bazhenov/eload/3d/heatsink.step

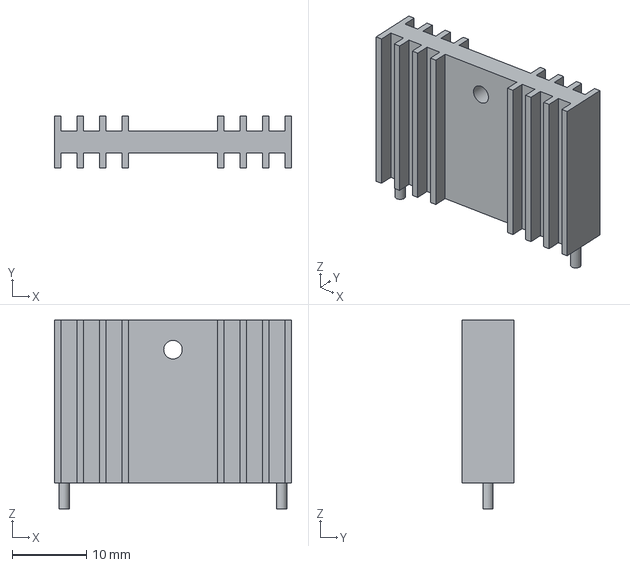
[picture p1: CAD file, 2026-01-11]
3d/heatsink.step
32.0 x 7.00 x 25.5 mm
