bazhenov/eload/3d/G5Q-1-EU_DC12.stp

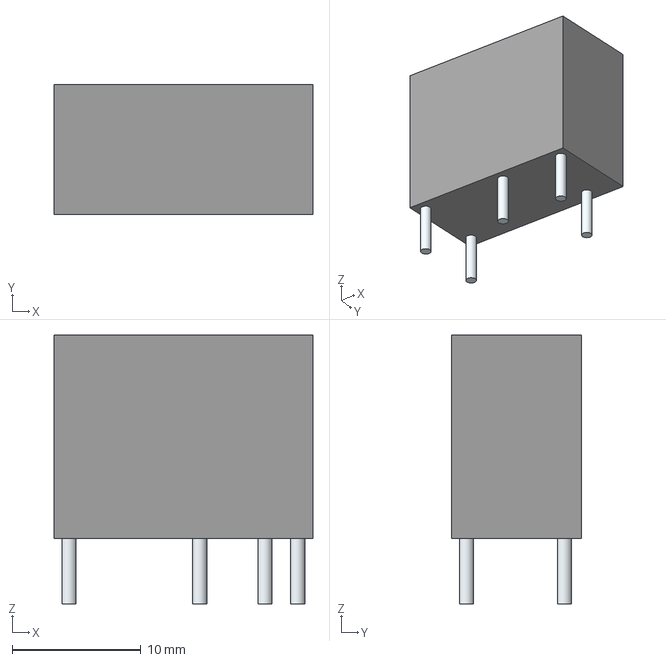
[picture p2: CAD file, 2026-01-10]
3d/G5Q-1-EU_DC12.stp
20.1 x 10.2 x 20.9 mm
Leads
