bazhenov/eload/(list of files, cad)

Other CAD files:
3d/heatsink.FCStd
