bazhenov/eload/eload.kicad_pcb

## KiCad design eload.kicad_pcb (2026-01-17)

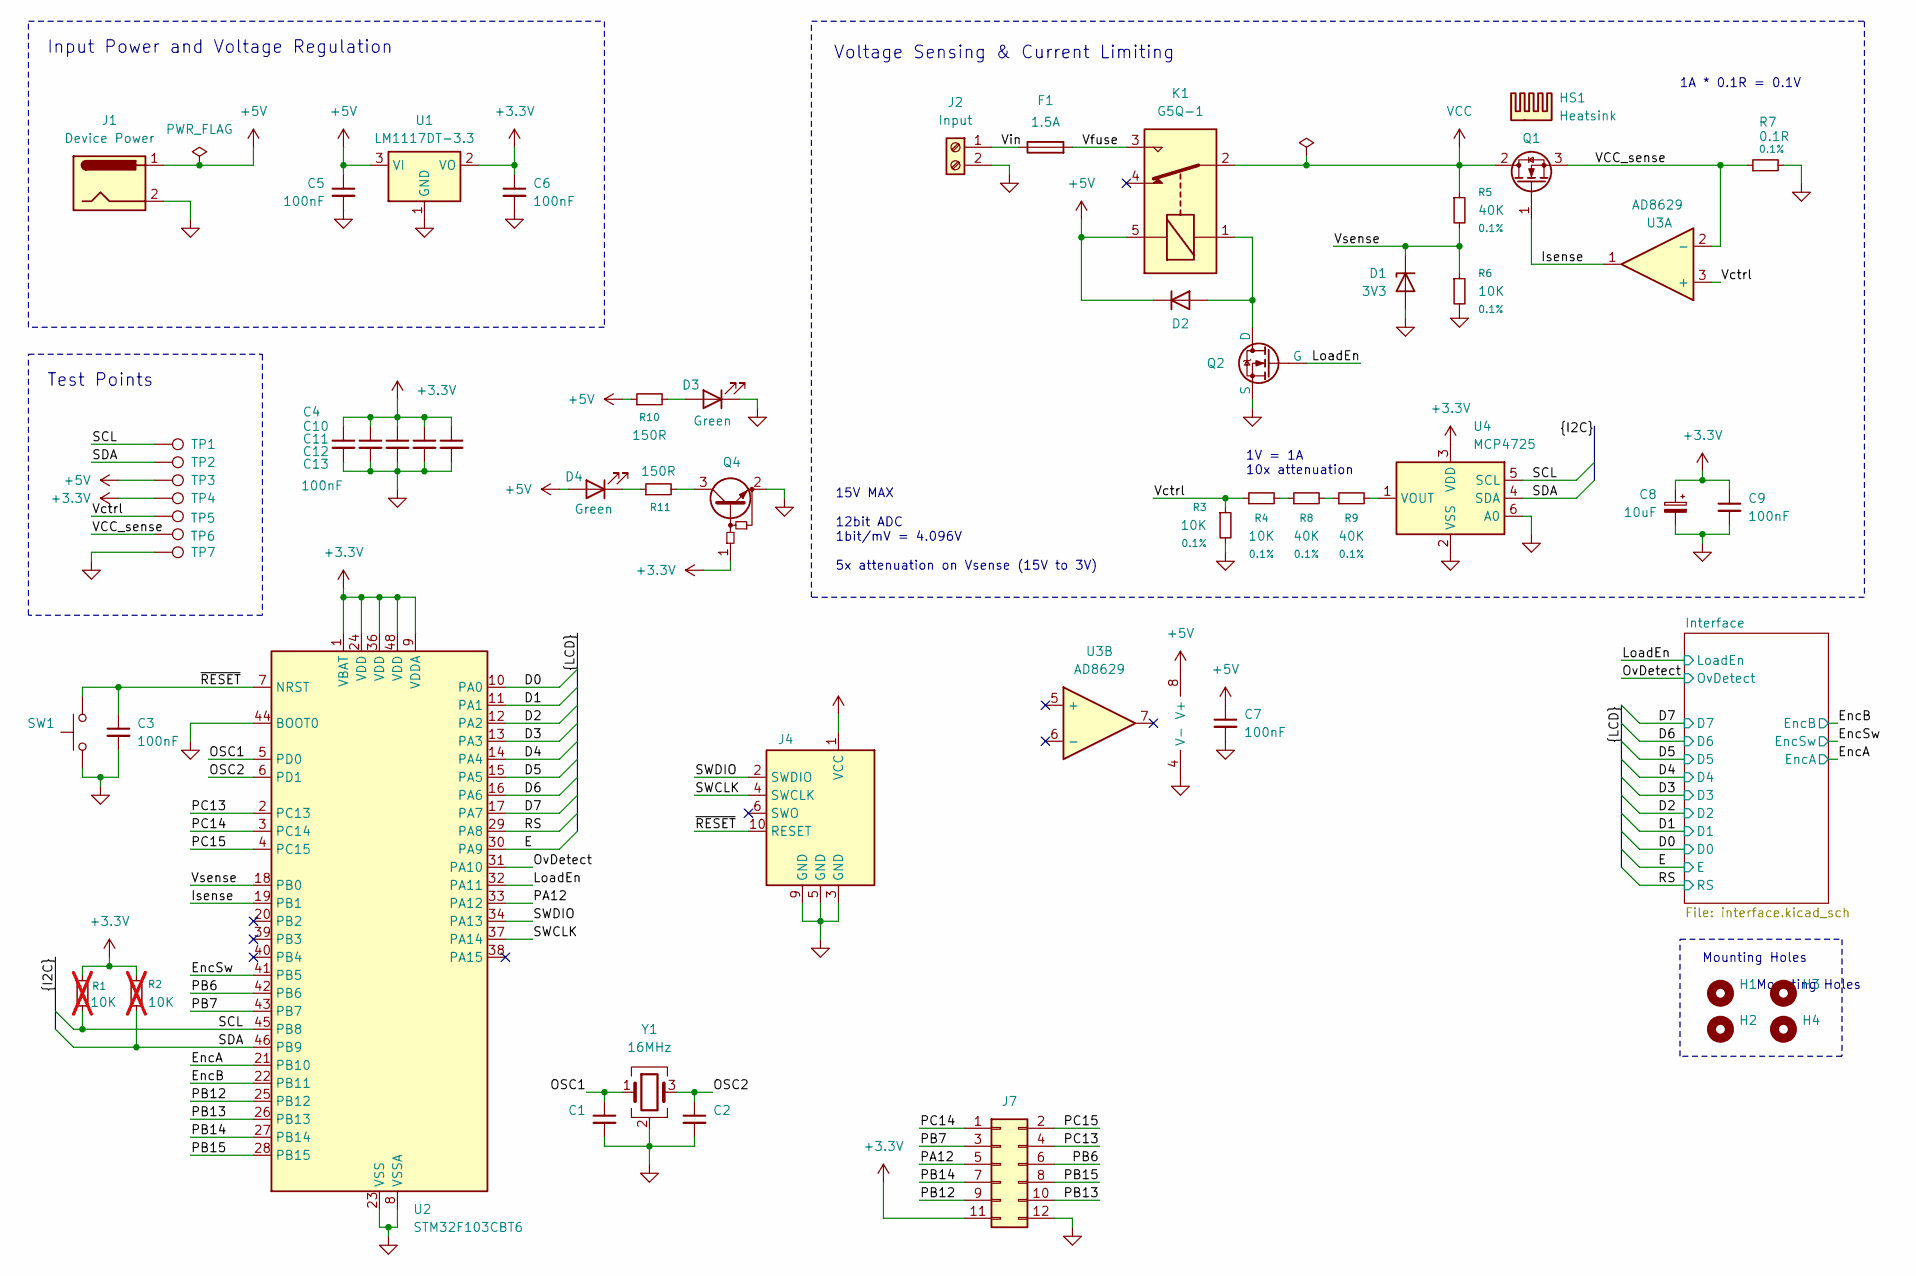
[picture p3: schematic eload.kicad_sch, Bench Electronic Load]

Parts:
C1, C2: 20pF; C_0805_2012Metric_Pad1.18x1.45mm_HandSolder; LCSC Part # C149606
C3, C4, C5, C6, C7, C9, C10, C11, C12, C13: 100nF; C_0805_2012Metric_Pad1.18x1.45mm_HandSolder; LCSC Part # C49678
C8: 10uF; CP_EIA-3216-18_Kemet-A_HandSolder; LCSC Part # C110055
D1: BZT52C3V3S; D_SOD-323_HandSoldering; LCSC Part # C507913
D2: MBR120VLSFT1G; D_SOD-123F; LCSC Part # C223608
D3, D4: 17-215/GHC-YR1S2/4T; LED_0805_2012Metric_Pad1.15x1.40mm_HandSolder; LCSC Part # C2985995
F1: 1.5A; R_Axial_DIN0204_L3.6mm_D1.6mm_P7.62mm_Horizontal; LCSC Part # C178932
H1, H2, H3, H4: MountingHole; MountingHole_3.2mm_M3_DIN965
HS1: Heatsink; XSD1226-362; LCSC Part # C4657
J1: Device Power; BarrelJack_Horizontal; LCSC Part # C7498153
J2: Input; TerminalBlock_CUI_TB007-508-02_1x02_P5.08mm_Horizontal; LCSC Part # C8465
J4: SWD Header; IDC-Header_2x05_P2.54mm_Vertical; LCSC Part # C5665
J7: Conn_02x06_Odd_Even; PinHeader_2x06_P2.54mm_Vertical
K1: G5Q-1; Relay_SPDT_Omron-G5Q-1; LCSC Part # C397241
Q1: RFP30N06LE-VB; TO-220-3_Vertical; LCSC Part # C878812
Q2: HL 40N05; SOT-23-3; LCSC Part # C7543825
Q4: DTC043ZUBTL; SOT-323_SC-70; LCSC Part # C962655
R1, R2: 10K; R_0805_2012Metric_Pad1.20x1.40mm_HandSolder; LCSC Part # C110775; not fitted
R3, R4, R6: 10K; R_0805_2012Metric_Pad1.20x1.40mm_HandSolder; LCSC Part # C110775
R5, R8, R9: 40K; R_0805_2012Metric_Pad1.20x1.40mm_HandSolder; LCSC Part # C865475
R7: 0.1R; R_1206_3216Metric_Pad1.30x1.75mm_HandSolder; LCSC Part # C7467250
R10, R11: 150R; R_0805_2012Metric_Pad1.20x1.40mm_HandSolder; LCSC Part # C844818
SW1: SW_Push
TP1, TP2, TP7: TestPoint; TestPoint_Loop_D1.80mm_Drill1.0mm_Beaded
TP3, TP4, TP5, TP6: TestPoint; TestPoint_Pad_D1.5mm
U1: LM1117DT-3.3; SOT-223; LCSC Part # C126027
U2: STM32F103CBT6; LQFP-48_7x7mm_P0.5mm; LCSC Part # C8304
U3: AD8629; JEITA_SOIC-8_3.9x4.9mm_P1.27mm; LCSC Part # C653045
U4: MCP4725; SOT-23-6; LCSC Part # C144198
Y1: 16MHz; Crystal_SMD_3225-4Pin_3.2x2.5mm_HandSoldering; LCSC Part # C13738

Connections:
+3.3V: C4.1, C6.1, C8.1, C9.1, C10.1, C11.1, C12.1, C13.1, J4.1 (VCC), J7.11, Q4.1 (B), R1.1, R2.1, TP4.1, U1.2 (VO), U2.1 (VBAT), U2.9 (VDDA), U2.24 (VDD), U2.36 (VDD), U2.48 (VDD), U4.3 (VDD); also elsewhere on the board
+5V: C5.1, C7.1, D2.1 (K), D4.2 (A), J1.1, K1.5, R10.1, TP3.1, U1.3 (VI), U3.8 (V+); also elsewhere on the board
/D0: U2.10 (PA0); also elsewhere on the board
/D1: U2.11 (PA1); also elsewhere on the board
/D2: U2.12 (PA2); also elsewhere on the board
/D3: U2.13 (PA3); also elsewhere on the board
/D4: U2.14 (PA4); also elsewhere on the board
/D5: U2.15 (PA5); also elsewhere on the board
/D6: U2.16 (PA6); also elsewhere on the board
/D7: U2.17 (PA7); also elsewhere on the board
/E: U2.30 (PA9); also elsewhere on the board
/EncA: U2.21 (PB10); also elsewhere on the board
/EncB: U2.22 (PB11); also elsewhere on the board
/EncSw: U2.41 (PB5); also elsewhere on the board
/Isense: Q1.1 (G), U2.19 (PB1), U3.1
/LoadEn: Q2.2 (G), U2.32 (PA11); also elsewhere on the board
/OSC1: C1.1, U2.5 (PD0), Y1.1
/OSC2: C2.1, U2.6 (PD1), Y1.3
/OvDetect: U2.31 (PA10); also elsewhere on the board
/PA12: J7.5, U2.33 (PA12)
/PB6: J7.6, U2.42 (PB6)
/PB7: J7.3, U2.43 (PB7)
/PB12: J7.9, U2.25 (PB12)
/PB13: J7.10, U2.26 (PB13)
/PB14: J7.7, U2.27 (PB14)
/PB15: J7.8, U2.28 (PB15)
/PC13: J7.4, U2.2 (PC13)
/PC14: J7.1, U2.3 (PC14)
/PC15: J7.2, U2.4 (PC15)
/RS: U2.29 (PA8); also elsewhere on the board
/SCL: R1.2, TP1.1, U2.45 (PB8), U4.5 (SCL)
/SDA: R2.2, TP2.1, U2.46 (PB9), U4.4 (SDA)
/SWCLK: J4.4 (SWCLK), U2.37 (PA14)
/SWDIO: J4.2 (SWDIO), U2.34 (PA13)
/VCC_sense: Q1.3 (S), R7.1, TP6.1, U3.2 (-)
/Vctrl: R3.1, R4.1, TP5.1, U3.3 (+)
/Vfuse: F1.2, K1.3
/Vin: F1.1, J2.1
/Vsense: D1.1 (K), R5.2, R6.1, U2.18 (PB0)
/~RESET: C3.1, J4.10 (RESET), SW1.2, U2.7 (NRST)
GND: C1.2, C2.2, C3.2, C4.2, C5.2, C6.2, C7.2, C8.2, C9.2, C10.2, C11.2, C12.2, C13.2, D1.2 (A), D3.1 (K), J1.2, J2.2, J4.3 (GND), J4.5 (GND), J4.9 (GND), J7.12, Q2.3 (S), Q4.2 (E), R3.2, R6.2, R7.2, SW1.1, TP7.1, U1.1 (GND), U2.8 (VSSA), U2.23 (VSS), U2.35 (VSS), U2.44 (BOOT0), U2.47 (VSS), U3.4 (V-), U4.2 (VSS), U4.6 (A0), Y1.2 (G), Y1.4 (G); also elsewhere on the board
unnamed: D2.2 (A), K1.1, Q2.1 (D)
unnamed: D3.2 (A), R10.2
unnamed: D4.1 (K), R11.1
unnamed: Q4.3 (C), R11.2
unnamed: R4.2, R8.1
unnamed: R8.2, R9.1
unnamed: R9.2, U4.1 (VOUT)
VCC: K1.2, Q1.2 (D), R5.1

Notes on the sheet:
Test Points
Voltage Sensing & Current Limiting
Input Power and Voltage Regulation
15V MAX 12bit ADC 1bit/mV = 4.096V 5x attenuation on Vsense (15V to 3V)
1A * 0.1R = 0.1V
1V = 1A 10x attenuation
Mounting Holes

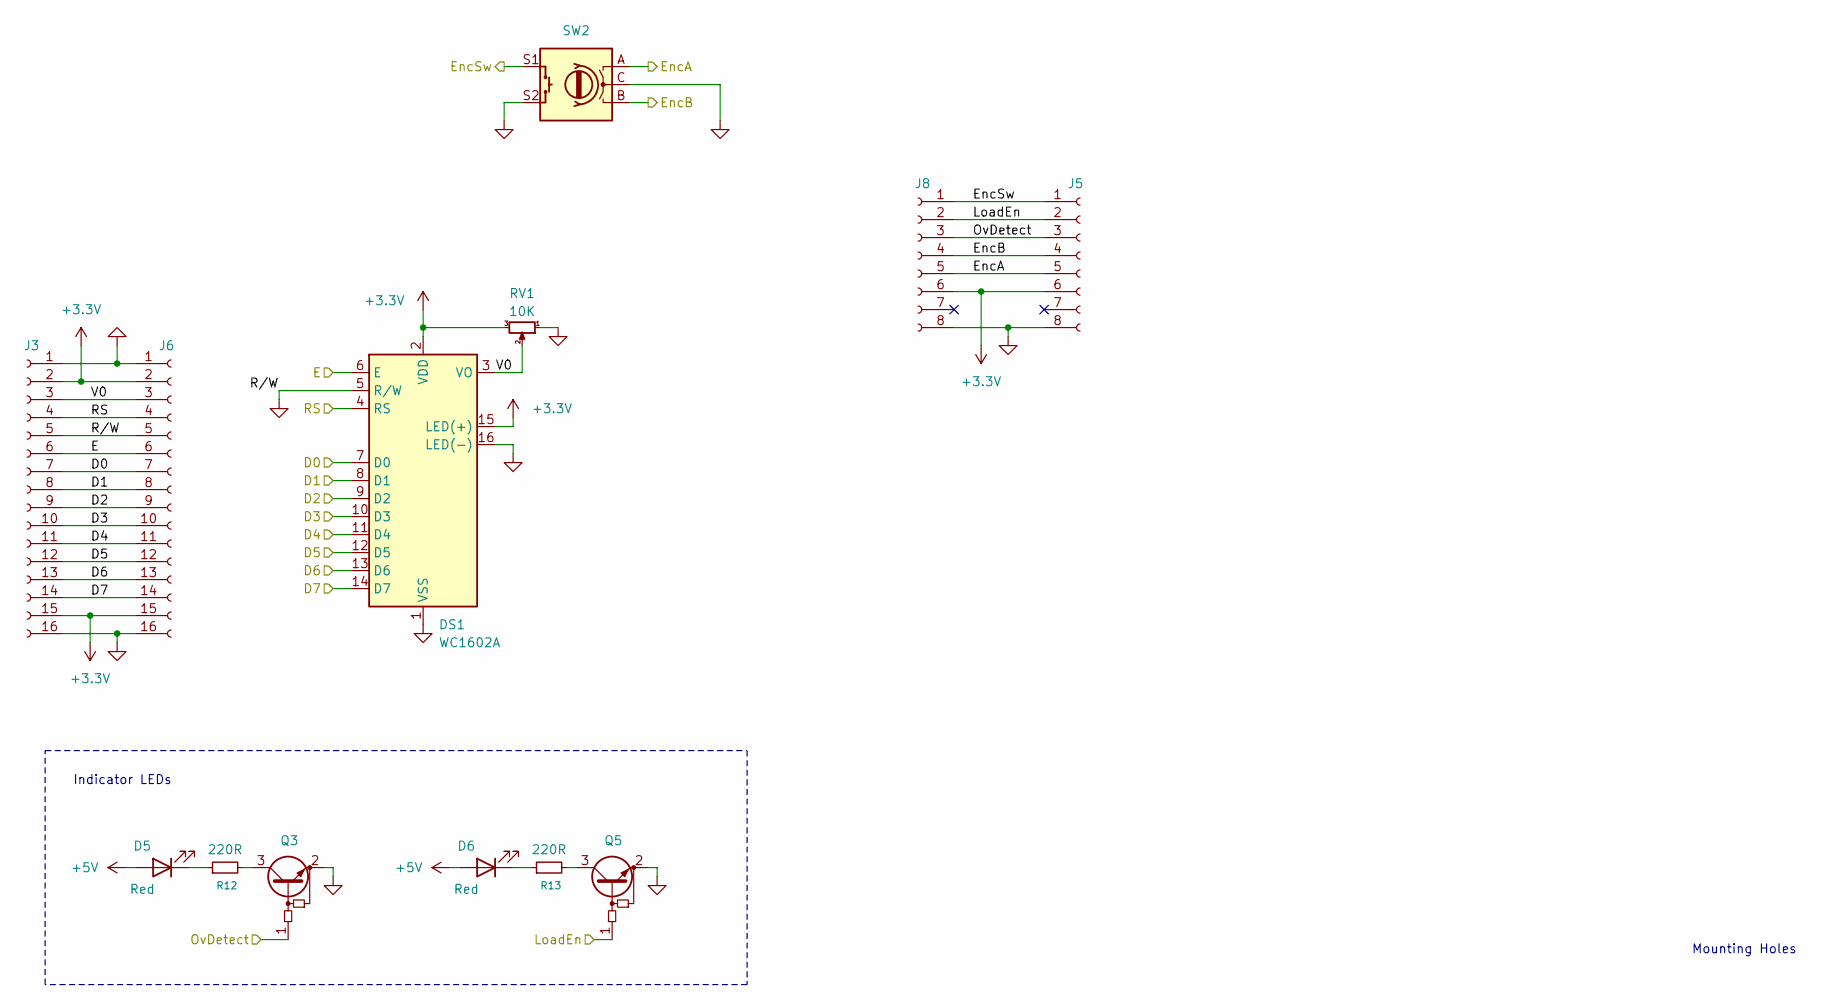
[picture p4: schematic interface.kicad_sch, Bench Electronic Load]

Parts:
D5, D6: 17-215/GHC-YR1S2/4T; LED_0805_2012Metric_Pad1.15x1.40mm_HandSolder; LCSC Part # C2971979
DS1: WC1602A
J3, J6: JST Header; JST_XH_B16B-XH-A_1x16_P2.50mm_Vertical; LCSC Part # C158022
J5, J8: Conn_01x08_Socket; JST_XH_B8B-XH-A_1x08_P2.50mm_Vertical
Q3, Q5: DTC043ZUBTL; SOT-323_SC-70; LCSC Part # C962655
R12, R13: 220R; R_0805_2012Metric_Pad1.20x1.40mm_HandSolder; LCSC Part # C844830
RV1: 10K; Potentiometer_Bourns_3266W_Vertical; LCSC Part # C49241482
SW2: RotaryEncoder_Switch; RotaryEncoder_Bourns_Vertical_PEC12R-3x17F-Sxxxx; LCSC Part # C5331618

Connections:
+3.3V: DS1.2 (VDD), DS1.15 (LED(+)), J3.2, J3.15, J5.6, J6.2, J6.15, J8.6, RV1.3; also elsewhere on the board
+5V: D5.2 (A), D6.2 (A); also elsewhere on the board
/D0: J3.7, J6.7; also elsewhere on the board
/D1: J3.8, J6.8; also elsewhere on the board
/D2: J3.9, J6.9; also elsewhere on the board
/D3: J3.10, J6.10; also elsewhere on the board
/D4: J3.11, J6.11; also elsewhere on the board
/D5: J3.12, J6.12; also elsewhere on the board
/D6: J3.13, J6.13; also elsewhere on the board
/D7: J3.14, J6.14; also elsewhere on the board
/E: J3.6, J6.6; also elsewhere on the board
/EncA: J5.5, J8.5; also elsewhere on the board
/EncB: J5.4, J8.4; also elsewhere on the board
/EncSw: J5.1, J8.1; also elsewhere on the board
/Interface/V0: DS1.3 (VO), J3.3, J6.3, RV1.2
/LoadEn: J5.2, J8.2, Q5.1 (B); also elsewhere on the board
/OvDetect: J5.3, J8.3, Q3.1 (B); also elsewhere on the board
/RS: J3.4, J6.4; also elsewhere on the board
GND: DS1.1 (VSS), DS1.5 (R/W), DS1.16 (LED(-)), J3.1, J3.5, J3.16, J5.8, J6.1, J6.5, J6.16, J8.8, Q3.2 (E), Q5.2 (E), RV1.1, SW2.C, SW2.S2; also elsewhere on the board
unnamed: D5.1 (K), R12.1
unnamed: D6.1 (K), R13.1
unnamed: Q3.3 (C), R12.2
unnamed: Q5.3 (C), R13.2

Notes on the sheet:
Mounting Holes
Indicator LEDs

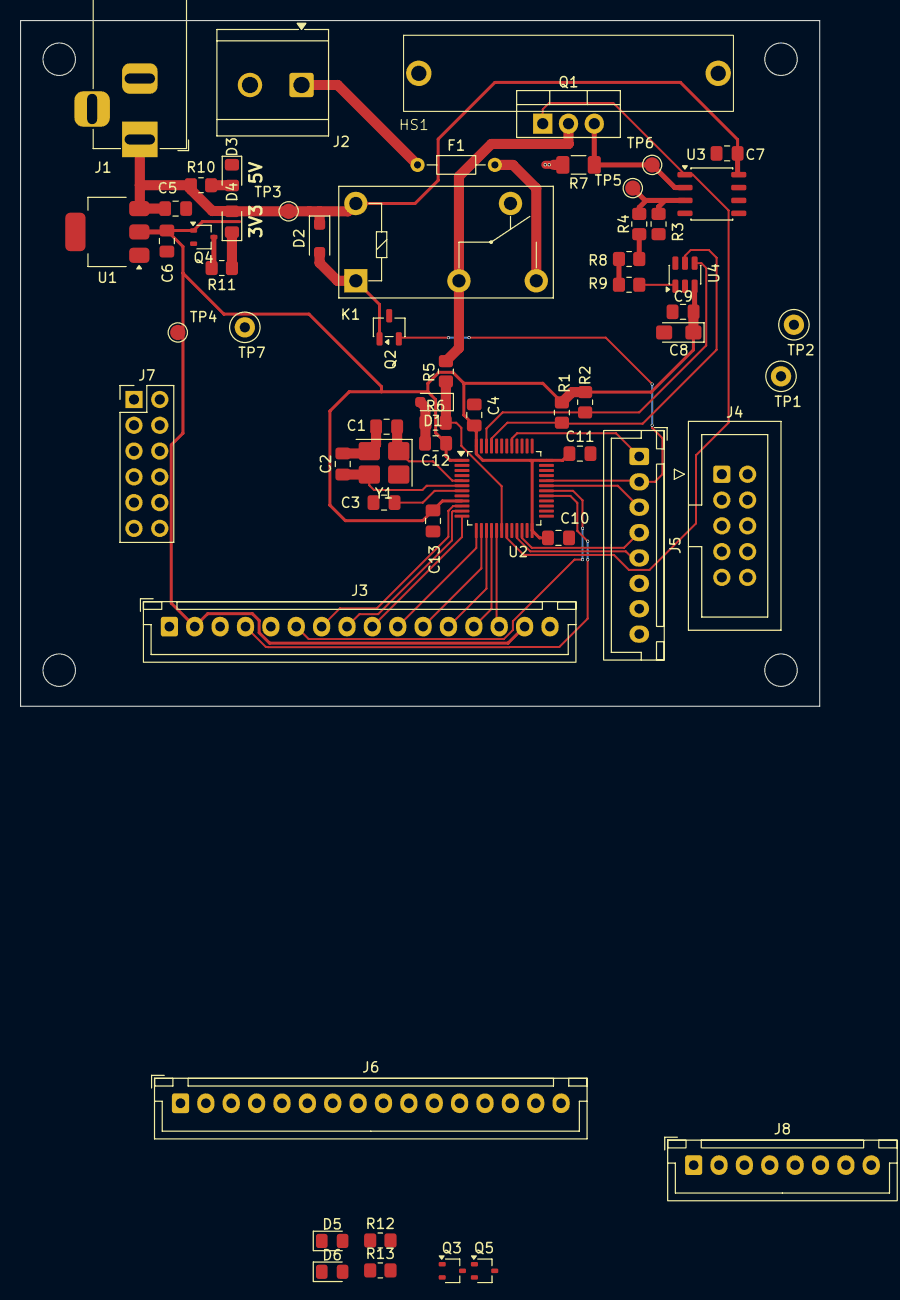
[picture p5: board eload.kicad_pcb from above]

Board: 2 copper layers, 78.7 x 67.6 mm, 64 parts (0 on the bottom side), 54 nets.
