bazhenov/eload/(commit log)

2025-11-24 Schematics updated
    [eload.kicad_sch]
2025-11-25 Schematics - Power Rail
    [eload.kicad_sch]
2025-11-26 Schematics updated
    - fuse added
    - rotary encoder connected
    - LCD added
    - switches added
    - minor fixes
    [eload.kicad_sch]
2025-11-26 Changes to schematics
    [eload.kicad_sch]
2025-11-29 Working on ERC checks
    [eload.kicad_sch]
2025-11-30 SWD header
    [eload.kicad_sch]
2025-12-11 Changing encoder pins to PB10/11
    [eload.kicad_sch]
2025-12-11 Encoder/Led experiment
2025-12-13 hd44780 driver added
2025-12-13 Remote unneded buttons for now
    [eload.kicad_sch]
2025-12-19 WIP schematic
    [eload.kicad_sch]
2025-12-19 Update footprints
    [eload.kicad_sch]
2025-12-21 Updates in a schematics
    [eload.kicad_sch]
2025-12-25 Simulation for a IRLML6344 MOSFET
2025-12-25 Move AD8629 power rail to 5V
    [eload.kicad_sch]
2025-12-25 Routing power plane for STM32
    [eload.kicad_pcb, eload.kicad_sch]
2025-12-29 Banana connector
    [eload.kicad_sch]
2025-12-29 Replace 89.8K resistor with 10+40+40K
    [eload.kicad_sch]
2025-12-29 Input Relay added
    OMRON G5Q-1
    [eload.kicad_sch]
2025-12-30 Indicator LEDs added, pin header symbol changed
    [eload.kicad_sch]
2026-01-04 Putting SWD header in a project local library
    [eload.kicad_sch]
2026-01-04 Split schematics into 2 pages
    [eload.kicad_sch, interface.kicad_sch]
2026-01-04 EMF supressing diode and relay MOSFET has been choosed
    [eload.kicad_sch]
2026-01-04 Biased NPN transistor correct schematic symbol, Resistor values
    [eload.kicad_sch, interface.kicad_sch]
2026-01-10 3D models added, mounting holes added
    [G5Q-1-EU_DC12.stp, eload.kicad_pcb, eload.kicad_sch, heatsink.step, interface.kicad_sch]
2026-01-11 Update heatsink model
    [eload.kicad_pcb, heatsink.FCStd, heatsink.step]
2026-01-13 PCB routing and cleanup
    [eload.kicad_pcb, eload.kicad_sch]
2026-01-13 PCB routing
    [eload.kicad_pcb, eload.kicad_sch]
2026-01-16 Transistor updated to MOSFET
    [eload.kicad_pcb, eload.kicad_sch]
2026-01-16 Update digital transistor to more solderable by hand
    [eload.kicad_pcb, eload.kicad_sch, interface.kicad_sch]
2026-01-16 Update to KiCad 9.0.7 library
    [eload.kicad_sch]
